tud-pses/powerpathcontroller/doc/ppc.pdf

0.1 Anforderungen

Umschalten zwischen den beiden Spannungsquellen Netzteil und Akku nach folgendem Schema:
- Wenn das Netzteil angeschlossen ist, dann soll dieses, unabhängig von der Akkuspannung, das System speisen. (FF)
- Wenn der Akkupack alleine angeschlossen ist, und dessen Spannung unter einen bestimmten Wert fällt, soll der Akku abgeschaltet werden, und keine Ausgangsspannung zur Verfügung gestellt werden. (WF)
- Zusätzlich soll eine Warnung ausgegeben werden, wenn die Akkuspannung unter eine bestimmte die Grenze fällt. Die Zeit bis zur Abschaltung muss ausreichen, „stressfrei“ das Auto an das Netzteil zu hängen. Diese Warnung soll aber nur ausgegeben werden, wenn tatsächlich ein Akkupack eingesetzt ist. (FF)
- Dar Zustand soll in geeigneter Weise signalisiert werden. (WF)

Eigenschaften Verbraucher
Der zulässige Bereich an Eingangsspannungen für das Mainboard ist 10 V bis 19 V (laut Händler) bzw. 8 V bis 19 V (laut Datenblatt).

Eigenschaften Netzteil
Es handelt sich um ein Schaltnetzteil mit 12 V Nennspannung und 50W Nennleistung.
Das verwendete Netzteil besitzt keine ausgeprägt höhere Leerlaufspannung. (Gemessen sind 12,15 V im Leerlauf, gegenüber 11,96 V bei ausgeschaltetem Rechner (Standby) und 12,14 V bei laufendem Rechner (ohne größere Prozessorlast, mit baugleichem Netzteil).)

Eigenschaften Akkupack
Es handelt sich um ein LiFe-Akkupack mit vier Zellen.
Das Akkupack kann Spannungen bis knapp unter 15 V ausweisen, wenn es gerade vom Ladegerät getrennt wird. (Die verwendete Schutzschaltung würde bei 15,6 V abschalten.)
Die Spannung im Betriebsbereich liegt zwischen 13,25 V und 12,5 V und ist von der Belastung abhängig. Der „makroskopische“ Innenwiderstand (d. h. nach Einschwingvorgängen) ist im Bereich von 65mΩ bis 100mΩ gemessen. Der „instantane“ Innenwiderstand (direkte Spannungsänderung geteilt durch Stromänderung, ohne Einschwingvorgänge abzuwarten) beträgt ca. 30mΩ.
Bei ca. 9,2 V schaltet die Schutzschaltung ab, wobei es im Sinne einer längeren Lebensdauer auch sinnvoll wäre, den Akku vorher von der Last zu trennen. Die nominelle Entladeschlussspannung liegt (laut Wikipedia) bei 10 V bis 11,2 V.

0.2 Abgeleitete Anforderungen

0.2.1 Spannungsgrenzen

Netzteil
- Überspannung : > 14 V
- Unterspannung : < 9,5 V (> 10,5 V)

Die Überspannungsgrenze könnte prinzipiell auch auf 19 V gesetzt werden, da das Mainboard das aushält. Allerdings erhöht das den theoretisch möglichen Umschaltspitzenstrom erheblich, und eine Notwendigkeit, das System mit anderen Netzteilen als den ausgewählten verwenden zu können, besteht nicht.
Die Untergrenze ist auf 9,5 V gelegt, damit eine gewisse Reserve bezüglich einem Spannungseinbruch beim Umschalten auf das Netzteil besteht. Dies stellt auch die absolute Untergrenze dar, wenn man einen Spannungseinbruch von 1 V während des Umschaltens am Ausgang zulässt. Durch die Unsicherheiten kann die tatsächliche Grenze auf 9 V sinken, und damit besteht nur noch 1 V Reserve zu der Mindestspannung von 8 V des Rechners.
Die große Hysterese für die Untergrenze dient dazu, denn quellenseitigen Stützkondensator möglichst klein halten zu können.

Akkupack
- Überspannung : > 15,5 V (< 15 V)
- Unterspannung : < 10,5 V (> 11,5 V)

Mit der Überspannungsgrenze von 15,5 V ist eine Verwendung von auch etwas sehr stark geladenen Akkus möglich. Die Untergrenze von 10,5 V liegt in der Mitte des nominellen Bereichs der Ladeschlussspannung und schützt den Akku vor zu tiefer Entladung. (Die 9,2 V des LiFe-Schützers sind schon sehr niedrig gewählt und schützen mehr vor Zerstörung als vor übermäßigen Verschleiß.) Testmessungen zeigen auch, dass man bei einer niedrigeren Grenze auch nicht viel Zeit gewinnt. (Bei 20W ungefähr eine Minute, bei neuem Akku.)
Die Hysterese von 1 V soll sicherstellen, dass der Akku nicht wieder zugeschaltet wird, wenn sich die Akkuspannung im Leerlauf wieder erhöht. Testmessungen zeigen einen sehr deutlichen Anstieg der Ausgangsspannung des Akkus nach Abschalten der Last, wenn der Akku stark entladen ist. Dieser Anstieg ist umso größer, je größer der Entladestrom ist. Es ist auch mit der Hysterese von 1 V und höheren Entnahmeleistungen nicht ausgeschlossen, dass der Akku sich wieder zuschalten könnte. Letztlich betrifft das aber nur den Fall, dass der Akku abgeschaltet wurde und kein Netzteil angesteckt ist.
Größer kann die Hysterese nicht gewählt werden, da dann der Fall auftreten könnte, dass sich nach dem manuellen Ausschalten bei teilentladenen Akku es sich nicht mehr einschalten lässt. Dies wäre ein unerwünschtes Verhalten.

Warnung Akkupack
- Überspannung : ∞ (nicht überwacht)
- Unterspannung : < 12 V (> 12,25 V)

Bei einer Warngrenze von 12 V und einer Abschaltgrenze von 10,5 V verbleiben bei 20W Leistungsaufnahme ungefähr 5min zwischen Warnung und Abschalten. Bei 60W wären es noch ca. 2,5min. (Jeweils am neuen Akku gemessen.) Dies reicht in allen Fällen für ein „gemütliches“ Anstecken des Netzteils.

0.2.2 Signalisierungen

- LED Netz: an, wenn „Netz VALID“
- LED Akku: an, wenn „Akku VALID“
- LED Akkuwarnung: an, wenn „Akkutest VALID“ und „Akku VALID“

- LED groß, blinkend und Summer Akkuwarnung: an, wenn „Akkutest VALID“ und „Netz VALID“

– Es muss nicht zusätzlich überprüft werden, ob „Akku VALID“ ist. Sollte dies nicht der Fall sein, stünde gar keine Spannung zur Verfügung, und damit würde auch keine Warnung signalisiert werden.
– Die Elemente Blink-LED und Summer müssen nur für den Spannungsbereich zwischen der Unterspannungsgrenze des Akkus und der Unterspannungsgrenze der Akkuwarnung spezifiziert sein. (Dies ist wesentlich, da viele in Frage kommenden Bauteile bis 14 V geeignet sind, und damit nicht an allen zulässigen Akku- und Netzteilspannungen betrieben werden dürfen.)

0.3 Auslegung

0.3.1 Spannungsgrenzen

Gleichungen

Es werden die Bauteilbenennungen aus Abbildung 0.1 verwendet.

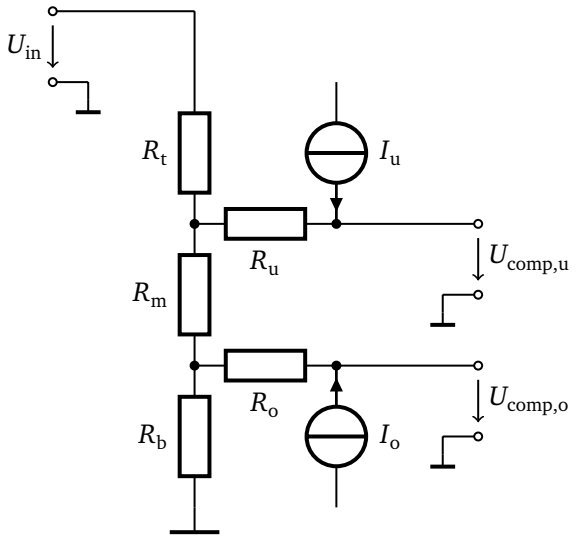
[picture p1: figure]
Uin; Ucomp,u; Ucomp,o

Abbildung 0.1: Schaltplan zur Festlegung der OV/UV-Grenzen

Io = Io,leak | ( +Ihys )
Iu = Iu,leak | ( −Ihys )

Ihys =

63mV
Rhys

Uin,o =

Rt + Rm + Rb
Rb
- Ucomp,o − Rt
- Iu −
Rt + Rm +

Ro

·(Rt + Rm + Rb
)
Rb
- Io

Uin,u =

Rt + Rm + Rb
Rm + Rb
- Ucomp,u −
Rt +

Ru

·(Rt + Rm + Rb
)
Rm + Rb
- Iu −

RtRb
Rm + Rb
- Io

Für die Nominalpunkte ergibt sich

Uov =

Rt + Rm + Rb
Rb
- 1 V

Uuv =

Rt + Rm + Rb
Rm + Rb
- 1 V

Uov,hys =

Rt + Rm +

Ro

·(Rt + Rm + Rb
)
Rb
- Ihys

Uuv,hys =

Rt +

Ru

·(Rt + Rm + Rb
)
Rm + Rb
- Ihys

Festlegung der Bauteilwerte

Hysteresestrom
Da für den Akku eine sehr große Hysterese von 2 V vorgesehen ist, wird der höchstmögliche Hysteresestrom von 500 nA gewählt. Mit der Wahl

Rhys = 127 kΩ

ergibt sich

Ihys =

63mV
127 kΩ

= 496,1 nA

Grenzen Netzteil
Wegen der großen Hysterese ist die „Doppel-T-Struktur“ aus dem Datenblatt verwendet, die für diese Fälle empfohlen ist. Dabei besteht ein Freiheitsgrad, der hier mit der Wahl von Rt = 200 kΩ weggenommen ist. (Dieser Wert orientiert sich an den Werten in den Beispielschaltungen im Datenblatt.)
Mit
Rt = 200 kΩ | Rm = 8,45 kΩ | Rb = 15,0 kΩ | Ru = 200 kΩ | Ro = 20,0 kΩ

erhält man

Uov = 14,90 V | Uov,hys = 0,2512 V | ( Uov − Uov,hys = 14,65 V )

sowie

Uuv = 9,529 V | Uuv,hys = 1,045 V | ( Uuv + Uuv,hys = 10,57 V ) .

Grenzen Akku
Wegen der großen Hysterese ist die „Doppel-T-Struktur“ aus dem Datenblatt verwendet, die für diese Fälle empfohlen ist. Dabei besteht ein Freiheitsgrad, der hier mit der Wahl von Rt = 200 kΩ weggenommen ist. (Dieser Wert orientiert sich an den Werten in den Beispielschaltungen im Datenblatt.)
Mit
Rt = 200 kΩ | Rm = 6,80 kΩ | Rb = 14,3 kΩ | Ru = 174 kΩ | Ro = 51,0 kΩ

erhält man

Uov = 15,46 V | Uov,hys = 0,4938 V | ( Uov − Uov,hys = 14,97 V )

sowie

Uuv = 10,48 V | Uuv,hys = 1,004 V | ( Uuv + Uuv,hys = 11,48 V ) .

Grenzen Akkuwarnung
Mit
Rt = 200 kΩ | Rm = 18,2 kΩ | Rb = 0Ω | Ru = 0Ω | Ro = 0Ω

erhält man

Uuv = 11,99 V | Uuv,hys = 0,0992 V | ( Uuv + Uuv,hys = 12,09 V ) .

Unsicherheitsanalyse

Im Datenblatt sind mögliche Leckströme von

I{o, u},leak = ±20 nA

angegeben. Dazu besitzen die Spannungskomperatoren eine Unsicherheit von pm1,5%,

∆Ucomp,{o, u} = ±1,5% .

Geht man dazu noch von einer Unsicherheit von 1% für Ihys aus (um diese Unsicherheit gering zu halten, wird für Rhys ein 0,1%-Widerstand verwendet), kann die Unsicherheit der sich ergebenden Spannungsschwellen bestimmt werden.
In Abbildung 0.2 ist für jede Schwelle der Bereich der Unsicherheit eingetragen. Zusätzlich zu den oben angegebenen Unsicherheiten sind dabei noch die Unsicherheiten der Widerstände berücksichtigt. Dabei sind 1%-Widerstände (dünne Balken) sowie 0,1%-Widerstände (dünne Balken) berücksichtigt.
Die Schwellen streuen z. T. deutlich. Die Hysteresewerte sind jedoch relativ stabil.

U1,ov U1,ovh U1,uv U1,uvh | U2,ov U2,ovh U2,uv U2,uvh | U3,uv U3,uvh

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
Netzteil | Akku | Akkuwng.

U [V]

U1,ov,hysU1,uv,hysU2,ov,hysU2,uv,hysU3,uv,hys

0

0,2

0,4

0,6

0,8

1

1,2

U [V]

Abbildung 0.2: OV/UV-Grenzen mit Unsicherheit

0.3.2 Leistungspfade

Die „Leistungspfade“ bestehen aus den Mosfets mit der optionalen Slew-Rate-Schaltung sowie den Einund Ausgangskondensatoren.
Abgesehen vom Einschalten (d. h. vom Ausgangszustand, dass keine gültige Spannung anliegt) werden die Mosfets „hart“ geschaltet. Dies kann zu realtiv großen Ausgleichsströmen führen. Neben der Überlastung der Mosfets können diese hohen Ströme auch Spannungseinbrüche der Spannungsquellen hervorrufen, die dazu führen, dass diese den gültigen Bereich verlassen und damit wieder abgeschaltet werden.
Prinzipiell gibt es zwei Möglichkeiten:
- „Überdimensionierte“ Mosfets, die auch große Pulsströme überleben. Dann kann auf die Slew-Rate-Schaltung verzichtet werden.
- Mosfets, die sich am Dauerstrom orientieren.

Ausgangskondensator
Der Ausgangskondensator muss für die Zeit der Umschaltung den Rechner speisen. Die Ausgangsspannung während der Umschaltung soll um maximal 1 V absinken. Geht man von einem ESR von 50mΩ des Ausgangskondensators aus, ergibt sich bei 5 A ein Spannungsabfall von 250mV im Kondensator. Damit beträgt der maximal zulässige Spannungsabfall aufgrund der Entladung 750mA. Die Kapazität des Ausgangskondensators muss damit die Bedingung

CL ≥

5 A ·(3µs + 13µs + ∆tslewrate)
750mV erfüllen, wobei die 3µs + 13µs „systemimmanente“ Umschaltzeit, die überbrückt werden muss, ist. ∆tslewrate ist die zusätzliche Zeit aufgrund der optionalen Slew-Rate-Schaltung und wird nach Datenblatt über

∆tslewrate = 0,79 · RSCS

berechnet.

Eingangskondensator
Im Datenblatt ist für den Eingangskondensator die Bedingung

CU1 ≥ CL
·

U1 − Uout(init)

U1,droop

− 1

angegeben. Diese ergibt sich aus der Eingangsspannung U1 zum Zeitpunkt des Einschaltens der Spannungsquelle 1, der Ausgangsspannung Uout(init) zum Zeitpunkt des Einschaltens und dem zulässigen Spannungseinbruch U1,droop der Spannungsquelle 1. (Die Gleichung basiert auf der Betrachtung des Umladevorgangs von zwei parallelgeschalteten Kondensatoren.)

Eingangskondensator – Netzteil
Als einziges Kriterium wird hier erachtet, dass die Spannungsquelle 1 sich nicht direkt wieder abschalten darf, weil die Unterspannungsbedingung vorliegt. D. h.

U1,droop = U1 − U1,uv .

Damit erhält man

CU1
CL

≥

U1 − Uout(init)

U1 − U1,uv

− 1 .

Der kritische Fall ist hier, wenn das Netzteil durch Einstecken des Netzsteckers eingeschaltet wird. Die Spannung läuft dann „langsam“ hoch, und U1 − U1,uv entspricht gerade der Hysterese U1,uv,hys.
Die niedrigste Spannung Uout(init)
tritt auf, wenn der Akku kurz vor der Unterspannungsschwelle steht. Von dieser müssen dann noch die 0,75 V abgezogen werden, die die Spannung von CL während des Umschaltvorgangs fallen darf.
Somit ergibt sich

U1 = U1,uv + U1,uv,hys = 10,75 V

U1 − U1,uv = U1,uv,hys = 1 V
Uout(init) = 10 V − 0,75 V = 9,25 V.

CU1
CL

≥ 0,5

Eingangskondensator – Akku

CU2
CL

≥

U2 − Uout(init)

U2 − U2,uv

− 1 .

U2 = U2,uv + U2,uv,hys = 12 V

U2 − U2,uv = U2,uv,hys = 1 V
Uout(init) = 9 V − 0,75 V = 8,25 V.

CU2
CL

≥ 2,75

Bei einer Strombegrenzung auf 35 A und einem Innenwiderstand des Akkus von 30mΩ ergibt sich ein Spannungsabfall von 1,05 V. Damit kann sich der Akku in der Regel selber über der Unterspannungsgrenze halten und ein Kondensator ist nicht nötig.

Mosfet

„Schwacher“ Mosfet
- Typ: TPC8120
- VGS,min = −25 V, VGS,max = 20 V
- ID,maxPulse = −72 A
- ID,max = −18 A
- RDS(on) = 3,3mΩ bei VGS = −4,5 V RDS(on) = 2,6mΩ bei VGS = −10 V
- VGS(th),max = −0,8 V, VGS(th),min = −2 V
- CRSS,max = 1,18 nF

0.3.3 Einschaltstrombegrenzung und Pufferkondensator

Da die Eingangsbeschaltung des Boards nicht bekannt ist, kann hierfür kein Widerstand angegeben werden. Der Worst-Case ist ein geringer Widerstand, so dass dieser auf null gesetzt wird.

Rinrush = Rsource + Rfets + (RCL||Rpc,in)

Rfets = 2 · RDS(on) = 5,2mΩ

RCL ist der ESR des Ausgangskondensators der Schaltung und sollte über einen geringen ESR verfügen.

Umschalten von Akku auf Netzteil
Der worst-case Spannungssprung ist von der niedrigsten Akkuspannung minus dem Spannungsabfall während des Umschaltens (10 V − 1 V = 9 V) auf die höchste Netzteilspannung (15,25 V), also 6,25 V.

Rsource = 10mΩ

Rinrush = 20,2mΩ

Iinrush =

6,25 V
20,2mΩ

= 309 A

Umschalten von Netzteil auf Akku
Der worst-case Spannungssprung ist von der niedrigsten Netzteilspannung minus dem Spannungsabfall während des Umschaltens (9 V − 1 V = 8 V) auf die höchste Akkuspannung (16 V), also 8 V.

Rsource = 30mΩ

Rinrush = 40,2mΩ

Iinrush =

8 V
40,2mΩ

= 199 A

Rechnungen „kleiner Mosfet“

Der Kondensator CS der Slew-Rate-Schaltung wir laut Datenblatt zu CS = 10 · CRSS ≈ 12 nF
gewählt.
Mit einem maximalen Pulsstrom von

Iinrush = 35 A
ergibt sich nach dem iterativen Vorgehen aus dem Datenblatt letztlich CL = 470µF
und

RS ≥

(∆VG(sink) − VGS)· 1,2 · CL
CS
- Itot

=

(6 V − 2 V)· 564µF
12 nF · 35 A

= 5,4 kΩ .

Mit der Wahl
RS = 5,6 kΩ
ergibt sich mit
0,79 · RSCS = 0,79 · 5,6 kΩ · 12 nF = 53µs die Bedingung

CL ≥

5 A ·(3µs + 13µs + 53µs)
750mV

= 460µF
für das minimale CL

, welche mit CL = 470µF erfüllt ist.

Eingangskondensator

Rechnungen „großer Mosfet“

Der Ausgangskondensator muss die Bedingung

CL ≥

5 A ·(3µs + 13µs)
750mV

= 107µF

erfüllen. Der nächste Standardtyp (mit etwas Auswahl bei der Spannungsfestigkeit) ist

CL = 150µF .
