tud-pses/powerpathcontroller/doc/tikz/ext/OVUVLimits-ext.pdf

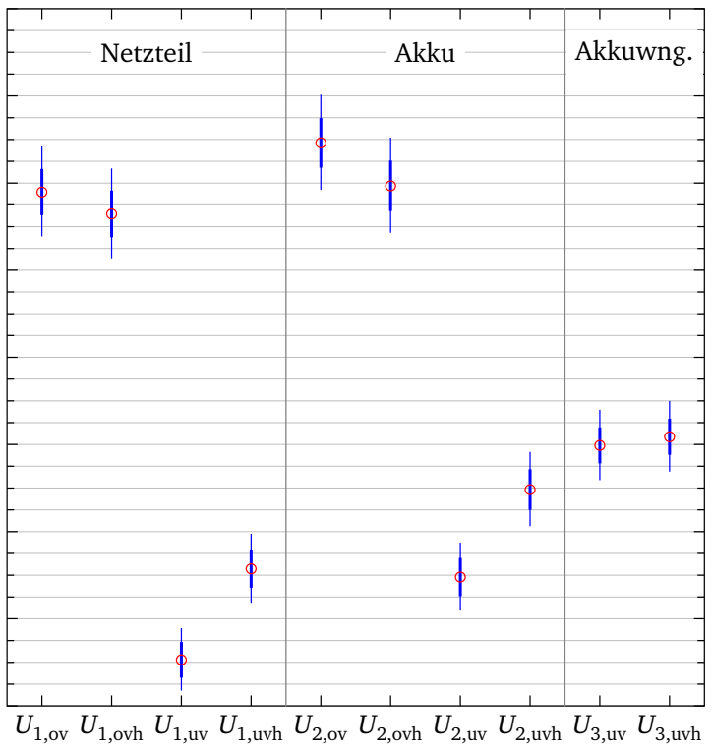
[picture p2: figure]
U1,ov U1,ovh U1,uv U1,uvh; U2,ov U2,ovh U2,uv U2,uvh; U3,uv U3,uvh; Netzteil; Akku; Akkuwng.

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
U [V]

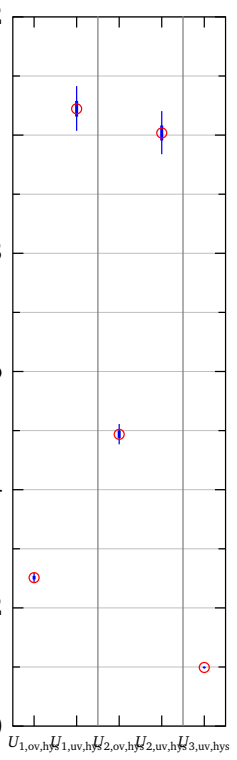
[picture p3: figure]
U1,ov,hysU1,uv,hysU2,ov,hysU2,uv,hysU3,uv,hys

0

0,2

0,4

0,6

0,8

1

1,2

U [V]
