tud-pses/powerpathcontroller/kicad/bom.xlsx

Sheet: Tabelle1
 |  |  |  |  |  |  |  |  | Bestellung
 |  |  |  |  |  |  |  | 29.32 € | Anzahl Platinen: | 2
Referenz | Bezeichnung/wesentliche Eigenschaften | Bauform | Bemerkung | Hersteller | Hersteller-Nr. | Lieferant | Lieferant-Nr. | Preis |  |  | Farnell | Reichelt
U1 | LTC4417 | SSOP 24 narrow |  | Linear | LTC4417IGN#PBF | Farnell | 2293163 | 9.17 € |  |  | 2293163, 2
Cin1 | 470u, 25V | Footprint für RAD FR 1.500/35 geeignet | 35V |  |  | Reichelt | RAD FR 470/35 | 0.23 € |  |  |  | RAD FR 470/35, 2
Cin2 | nb (470u, 25V vorsehen) | Footprint für RAD FR 1.500/35 geeignet | 35V
Cin3 | nb (220u, 25V vorsehen) |  | 35V
Cl1 | 470u, 25V | Footprint für RAD FR 1.500/35 geeignet | 35V |  |  | Reichelt | RAD FR 470/35 | 0.23 € |  |  |  | RAD FR 470/35, 2
Cv1 | 100n, 25V | 0603 | X7R |  |  | Farnell | 1759037 | 0.01 € |  |  | 1759037, 2
Cv2 | 100n, 25V | 0603 | X7R |  |  | Farnell | 1759037 | 0.01 € |  |  | 1759037, 2
Cvs1 | 120n, 25V | 0603 | X7R, 50V |  |  | Farnell | 1793828 | 0.11 € |  |  | 1793828, 2
Cvs2 | 120n, 25V | 0603 | X7R, 50V |  |  | Farnell | 1793828 | 0.11 € |  |  | 1793828, 2
Cs1 | 12n, 25V | 0603 | X7R, 50V |  |  | Farnell | 1865534 | 0.04 € |  |  | 1865534, 2
Cs2 | 12n, 25V | 0603 | X7R, 50V |  |  | Farnell | 1865534 | 0.04 € |  |  | 1865534, 2
Rt1 | 200k | 0603 | 1% |  |  | Farnell | 1469776 | 0.01 € |  |  | 1469776, 2
Rm1 | 8k45 | 0603 | 1% |  |  | Farnell | 2138418 | 0.01 € |  |  | 2138418, 2
Rb1 | 15k0 | 0603 | 1% |  |  | Farnell | 1469758 | 0.01 € |  |  | 1469758, 2
Ru1 | 200k | 0603 | 1% |  |  | Farnell | 1469776 | 0.01 € |  |  | 1469776, 2
Ro1 | 20k0 | 0603 | 1% |  |  | Farnell | 1469774 | 0.02 € |  |  | 1469774, 2
Rt2 | 200k | 0603 | 1% |  |  | Farnell | 1469776 | 0.01 € |  |  | 1469776, 2
Rm2 | 6k80 | 0603 | 1% |  |  | Farnell | 1469831 | 0.01 € |  |  | 1469831, 2
Rb2 | 14k3 | 0603 | 1% |  |  | Farnell | 2138430 | 0.01 € |  |  | 2138430, 2
Ru2 | 174k | 0603 | 1% |  |  | Farnell | 2138522 | 0.02 € |  |  | 2138522, 2
Ro2 | 51k0 | 0603 | 1% |  |  | Farnell | 1469822 | 0.01 € |  |  | 1469822, 2
Rt3 | 200k | 0603 | 1% |  |  | Farnell | 1469776 | 0.01 € |  |  | 1469776, 2
Rm3 | 18k2 | 0603 | 1% |  |  | Farnell | 1652845 | 0.01 € |  |  | 1652845, 2
_Rm3 | 18k2 | 0603 | 1% |  |  | Farnell | 1527611 | 0.08 € |  |  | 1527611, 2
Rhys1 | 127k | 0603 | 1% |  |  | Farnell | 2138509 | 0.02 € |  |  | 2138509, 2
R1 | 100k | 0603 | 1% |  |  | Reichelt | SMD-0603 100K | 0.08 € |  |  |  | SMD-0603 100K, 2
R2 | 100k | 0603 | 1% |  |  | Reichelt | SMD-0603 100K | 0.08 € |  |  |  | SMD-0603 100K, 2
R3 | 100k | 0603 | 1% |  |  | Reichelt | SMD-0603 100K | 0.08 € |  |  |  | SMD-0603 100K, 2
R4 | 4k7 | 0603 | 1% |  |  | Reichelt | SMD-0603 4,7K | 0.08 € |  |  |  | SMD-0603 4,7K, 2
R5 | 4k7 | 0603 | 1% |  |  | Reichelt | SMD-0603 4,7K | 0.08 € |  |  |  | SMD-0603 4,7K, 2
R6 | 4k7 | 0603 | 1% |  |  | Reichelt | SMD-0603 4,7K | 0.08 € |  |  |  | SMD-0603 4,7K, 2
Rs1 | 5k6 | 0603 | 1% |  |  | Reichelt | SMD-0603 5,6K | 0.08 € |  |  |  | SMD-0603 5,6K, 2
Rs2 | 5k6 | 0603 | 1% |  |  | Reichelt | SMD-0603 5,6K | 0.08 € |  |  |  | SMD-0603 5,6K, 2
D1 | LED, gn, 2mA | 0603 |  | Osram | LG L29K | Reichelt | LG L29K | 0.18 € |  |  |  | LG L29K, 2
D2 | LED, gn, 2mA | 0603 |  | Osram | LG L29K | Reichelt | LG L29K | 0.18 € |  |  |  | LG L29K, 2
D3 | LED, rt, 2mA | 0603 |  | Osram | LS L29K | Reichelt | LS L29K | 0.14 € |  |  |  | LS L29K, 2
D4 | Blink-LED, max 12,25 V, min 10 V |  | 8 mm, 800 mcd, 40° Abstrahlwinkel | Kingbright | L-796BSRC-B | Farnell | 1168559 | 0.75 € |  |  | 1168559, 2
_D4 | Blink-LED, max 12,25 V, min 10 V |  | 5 mm, 200 mcd, 60° Abstrahlwinkel | Lumex | SSL-LX5093BSRD | Farnell | 2062466 | 0.79 € |  |  | 2062466, 2
_D4 | Stecker, 2-polig |  |  |  |  | Reichelt | PS 25/2G BR | 0.27 € |  |  |  | PS 25/2G BR, 2
Ds1 | BAT54 | SOT-23 |  |  |  | Reichelt | BAT 54 SMD | 0.04 € |  |  |  | BAT 54 SMD, 2
Ds2 | BAT54 | SOT-23 |  |  |  | Reichelt | BAT 54 SMD | 0.04 € |  |  |  | BAT 54 SMD, 2
D5 | TVS, unidirektional, 16V | SOD123W | ClampVoltage: 26V | NXP | PTVS16VS1UR | Farnell | 1829241 | 0.14 € |  |  | 1829241, 2
D6 | TVS, unidirektional, 16V | SOD123W | ClampVoltage: 26V | NXP | PTVS16VS1UR | Farnell | 1829241 | 0.14 € |  |  | 1829241, 2
Q1 | TPC8120 | SOP 8 |  | Toshiba | TPC8120 | Farnell | 1901967 | 2.17 € |  |  | 1901967, 2
Q2 | TPC8120 | SOP 8 |  | Toshiba | TPC8120 | Farnell | 1901967 | 2.17 € |  |  | 1901967, 2
Q3 | TPC8120 | SOP 8 |  | Toshiba | TPC8120 | Farnell | 1901967 | 2.17 € |  |  | 1901967, 2
Q4 | TPC8120 | SOP 8 |  | Toshiba | TPC8120 | Farnell | 1901967 | 2.17 € |  |  | 1901967, 2
Q5 | TSM3401 | SOT 23 |  |  |  | Reichelt | TSM 3401 SMD | 0.25 € |  |  |  | TSM 3401 SMD, 2
Q6 | TSM3404 | SOT 23 |  |  |  | Reichelt | TSM 3404 SMD | 0.25 € |  |  |  | TSM 3404 SMD, 2
Q7 | TSM3404 | SOT 23 |  |  |  | Reichelt | TSM 3404 SMD | 0.25 € |  |  |  | TSM 3404 SMD, 2
Q8 | TSM3404 | SOT 23 |  |  |  | Reichelt | TSM 3404 SMD | 0.25 € |  |  |  | TSM 3404 SMD, 2
Q9 | TSM3404 | SOT 23 |  |  |  | Reichelt | TSM 3404 SMD | 0.25 € |  |  |  | TSM 3404 SMD, 2
Q10 | Summer, max 12,25 V, min 10 V |  |  | Ekulit | AL-60SP12 | Conrad | 710146 | 0.85 €
X1 | Leistungsstecker, 2 x 3-polig |  | 10 A |  |  | Reichelt | WAGO 713-1403 | 1.20 € |  |  |  | WAGO 713-1403, 2
X2 | Stecker uC, 5 polig |  | 3 A |  |  | Reichelt | PS 25/5G BR | 0.63 € |  |  |  | PS 25/5G BR, 2
 | Buchse für X1 |  |  |  |  | Reichelt | WAGO 713-1103 | 3.20 € |  |  |  | WAGO 713-1103, 2

Sheet: Tabelle2
Lieferant | Lieferant-Nr.
Farnell | 2293163
Reichelt | RAD FR 470/35
Reichelt | RAD FR 470/35
Farnell | 1759037
Farnell | 1759037
Farnell | 1793828
Farnell | 1793828
Farnell | 1865534
Farnell | 1865534
Farnell | 1469776
Farnell | 2138418
Farnell | 1469758
Farnell | 1469776
Farnell | 1469774
Farnell | 1469776
Farnell | 1469831
Farnell | 2138430
Farnell | 2138522
Farnell | 1469822
Farnell | 1469776
Farnell | 1652845
Farnell | 2138509
Reichelt | SMD-0603 100K
Reichelt | SMD-0603 100K
Reichelt | SMD-0603 100K
Reichelt | SMD-0603 4,7K
Reichelt | SMD-0603 4,7K
Reichelt | SMD-0603 4,7K
Reichelt | SMD-0603 5,6K
Reichelt | SMD-0603 5,6K
Reichelt | LG L29K
Reichelt | LG L29K
Reichelt | LS L29K
Farnell | 1168559
Farnell | 2062466
Reichelt | PS 25/2G BR
Reichelt | BAT 54 SMD
Reichelt | BAT 54 SMD
Farnell | 1829241
Farnell | 1829241
Farnell | 1901967
Farnell | 1901967
Farnell | 1901967
Farnell | 1901967
Reichelt | TSM 3401 SMD
Reichelt | TSM 3404 SMD
Reichelt | TSM 3404 SMD
Reichelt | TSM 3404 SMD
Reichelt | TSM 3404 SMD
Reichelt | SUMMER AL-60P12
Reichelt | WAGO 713/1403
Reichelt | PS 25/5G BR
Reichelt | WAGO 713-1103
