tud-pses/powerpathcontroller/kicad/PowerPathController.kicad_pcb

## KiCad design kicad/PowerPathController.kicad_pcb (2018-07-06)

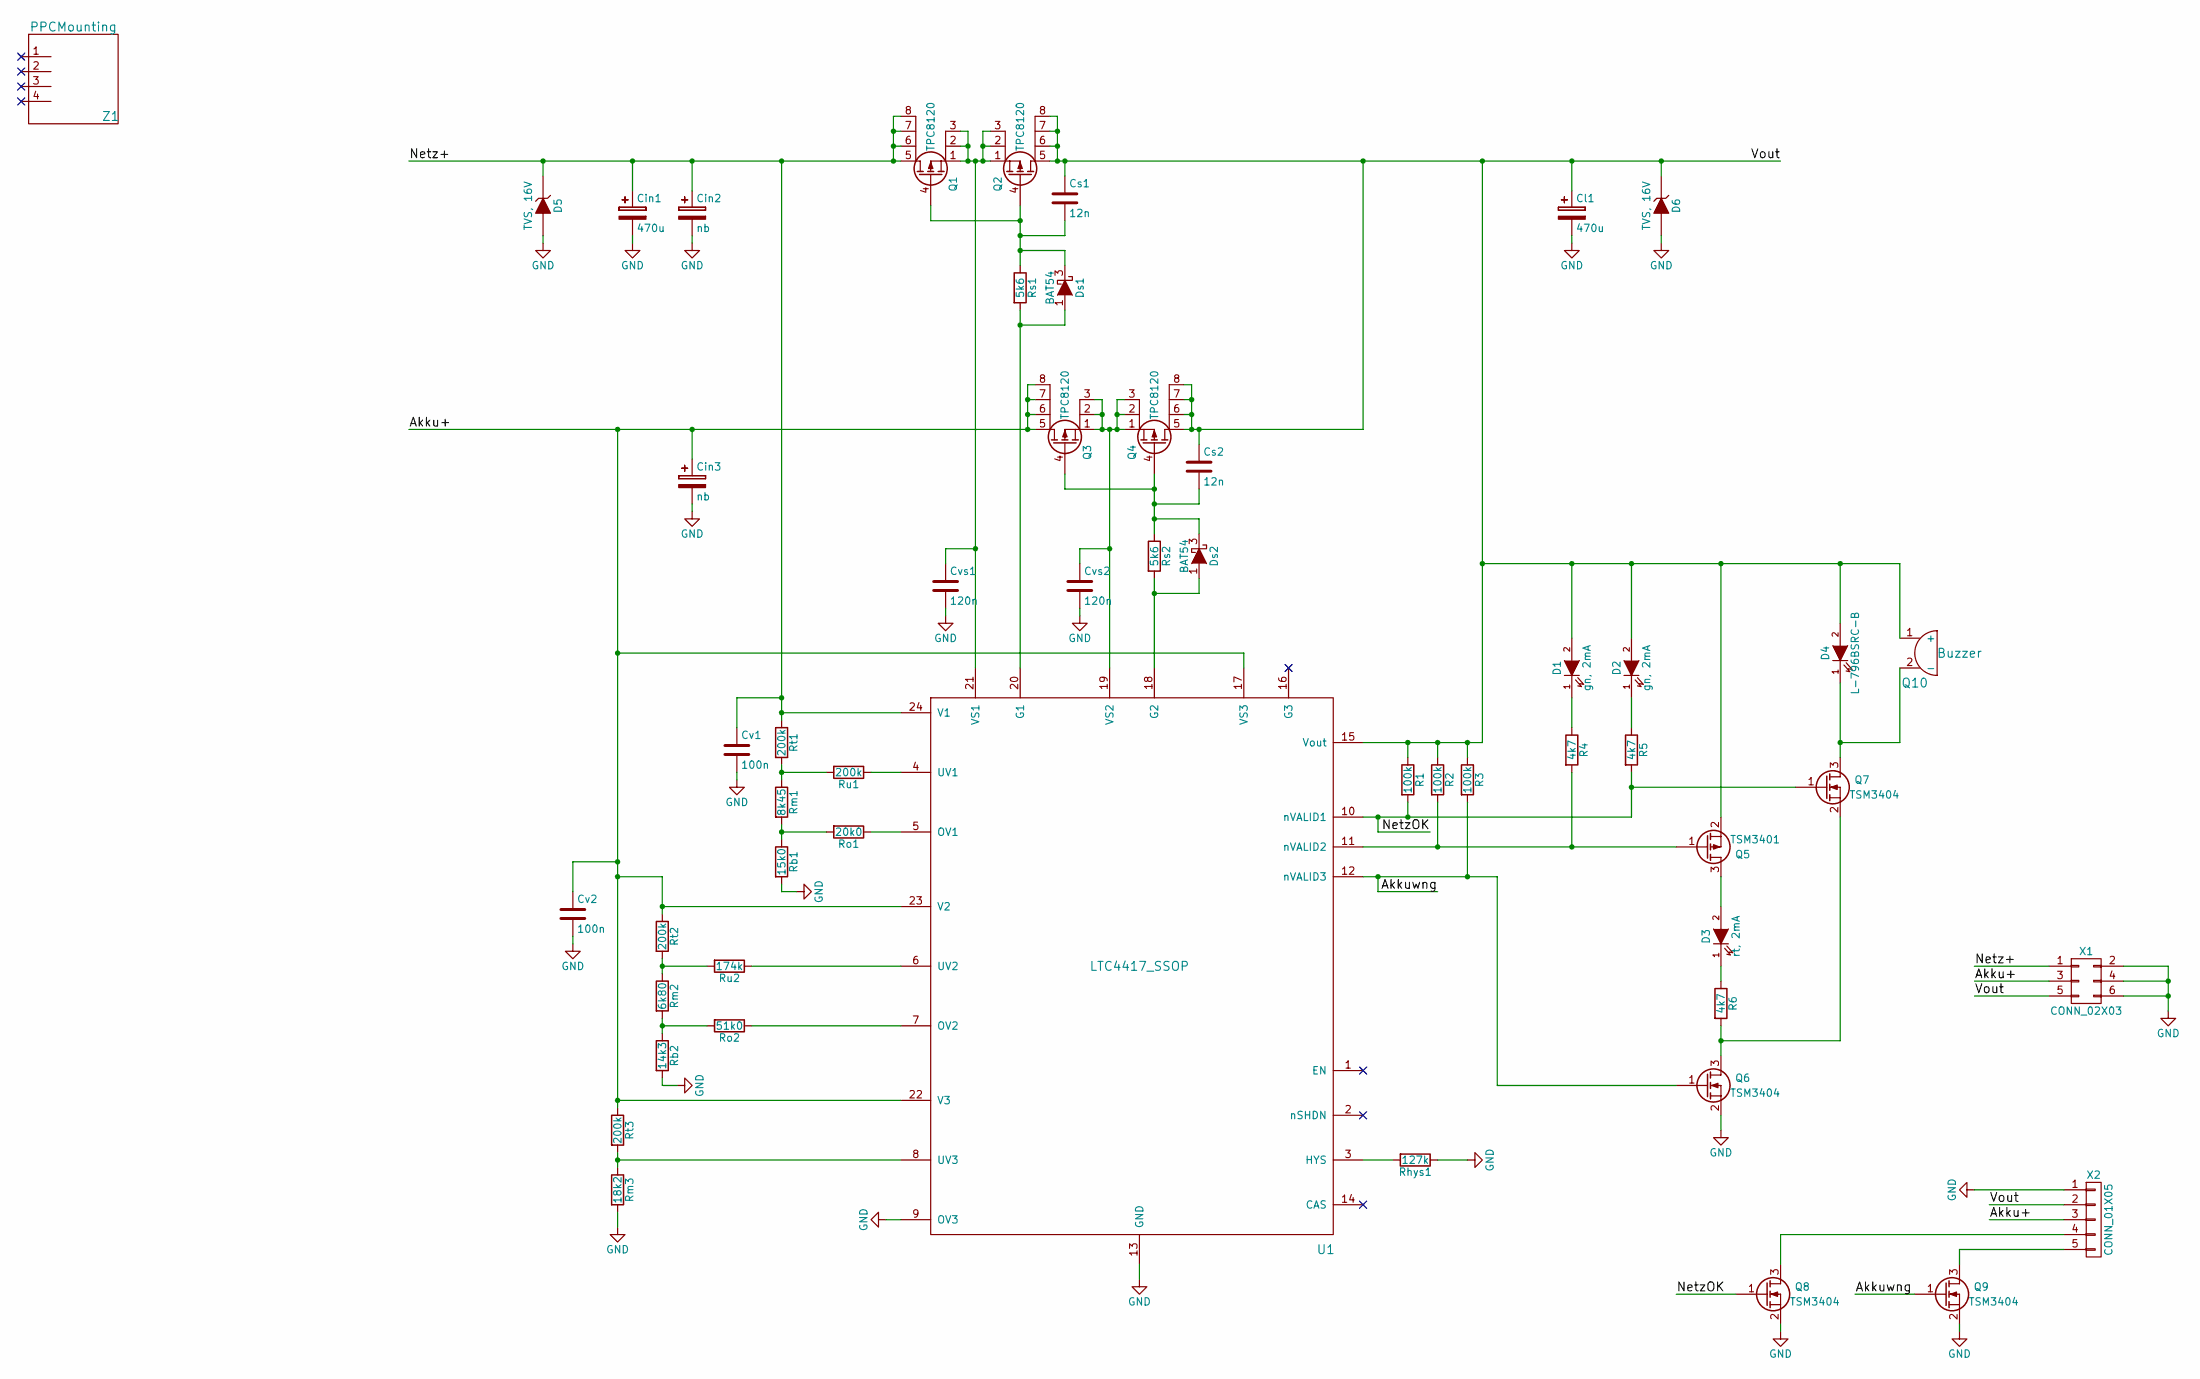
[picture p4: schematic PowerPathController.sch]

Parts:
Cin1: 470u; CPOL_12.5o8mm_5o3.5mm
Cin2: nb; CPOL_12.5o8mm_5o3.5mm
Cin3: nb; CPOL_8mm_3.5mm
Cl1: 470u; CPOL_12.5o8mm_5o3.5mm
Cs1, Cs2: 12n; C_0603_HandSoldering
Cv1, Cv2: 100n; C_0603_HandSoldering
Cvs1, Cvs2: 120n; C_0603_HandSoldering
D1, D2: gn, 2mA; LED-0603
D3: rt, 2mA; LED-0603
D4: L-796BSRC-B; LED-8MM_o_CONN_PS25_2G
D5, D6: TVS, 16V; SOD-123W
Ds1, Ds2: BAT54; SOT-23_Handsoldering
Q1, Q2, Q3, Q4: TPC8120; SOIC-8_3.9x4.9mm_Pitch1.27mm
Q5: TSM3401; SOT-23_Handsoldering
Q6, Q7, Q8, Q9: TSM3404; SOT-23_Handsoldering
Q10: Buzzer; Buzzer_AL-60P12
R1, R2, R3: 100k; R_0603_HandSoldering
R4, R5, R6: 4k7; R_0603_HandSoldering
Rb1: 15k0; R_0603_HandSoldering
Rb2: 14k3; R_0603_HandSoldering
Rhys1: 127k; R_0603_HandSoldering
Rm1: 8k45; R_0603_HandSoldering
Rm2: 6k80; R_0603_HandSoldering
Rm3: 18k2; R_0603_HandSoldering
Ro1: 20k0; R_0603_HandSoldering
Ro2: 51k0; R_0603_HandSoldering
Rs1, Rs2: 5k6; R_0603_HandSoldering
Rt1, Rt2, Rt3: 200k; R_0603_HandSoldering
Ru1: 200k; R_0603_HandSoldering
Ru2: 174k; R_0603_HandSoldering
U1: LTC4417_SSOP; SSOP-24_3.9x8.7mm_Pitch0.635mm
X1: CONN_02X03; WAGO_713-1403
X2: CONN_01X05; CONN_PS25_5G
Z1: PPCMounting; PPCMOUNTING

Connections:
/Akku+: Cin3.1, Cv2.1, Q3.5 (D), Q3.6 (D), Q3.7 (D), Q3.8 (D), Rt2.1, Rt3.1, U1.17 (VS3), U1.22 (V3), U1.23 (V2), X1.3, X2.3
/Akkuwng: Q6.1 (G), Q9.1 (G), R3.2, U1.12 (nVALID3)
/Netz+: Cin1.1, Cin2.1, Cv1.1, D5.1 (K), Q1.5 (D), Q1.6 (D), Q1.7 (D), Q1.8 (D), Rt1.1, U1.24 (V1), X1.1
/NetzOK: Q7.1 (G), Q8.1 (G), R1.2, R5.2, U1.10 (nVALID1)
/Vout: Cl1.1, Cs1.1, Cs2.1, D1.2 (A), D2.2 (A), D4.2 (A), D6.1 (K), Q2.5 (D), Q2.6 (D), Q2.7 (D), Q2.8 (D), Q4.5 (D), Q4.6 (D), Q4.7 (D), Q4.8 (D), Q5.2 (S), Q10.1 (+), R1.1, R2.1, R3.1, U1.15 (Vout), X1.5, X2.2
GND: Cin1.2, Cin2.2, Cin3.2, Cl1.2, Cv1.2, Cv2.2, Cvs1.2, Cvs2.2, D5.2 (A), D6.2 (A), Q6.2 (S), Q8.2 (S), Q9.2 (S), Rb1.2, Rb2.2, Rhys1.1, Rm3.2, U1.9 (OV3), U1.13 (GND), X1.2, X1.4, X1.6, X2.1
unnamed: Cs1.2, Ds1.3 (K), Q1.4 (G), Q2.4 (G), Rs1.1
unnamed: Cs2.2, Ds2.3 (K), Q3.4 (G), Q4.4 (G), Rs2.1
unnamed: Cvs1.1, Q1.1 (S), Q1.2 (S), Q1.3 (S), Q2.1 (S), Q2.2 (S), Q2.3 (S), U1.21 (VS1)
unnamed: Cvs2.1, Q3.1 (S), Q3.2 (S), Q3.3 (S), Q4.1 (S), Q4.2 (S), Q4.3 (S), U1.19 (VS2)
unnamed: D1.1 (K), R4.1
unnamed: D2.1 (K), R5.1
unnamed: D3.1 (K), R6.1
unnamed: D3.2 (A), Q5.3 (D)
unnamed: D4.1 (K), Q7.3 (D), Q10.2 (-)
unnamed: Ds1.1 (A), Rs1.2, U1.20 (G1)
unnamed: Ds2.1 (A), Rs2.2, U1.18 (G2)
unnamed: Q5.1 (G), R2.2, R4.2, U1.11 (nVALID2)
unnamed: Q6.3 (D), Q7.2 (S), R6.2
unnamed: Q8.3 (D), X2.4
unnamed: Q9.3 (D), X2.5
unnamed: Rb1.1, Rm1.2, Ro1.2
unnamed: Rb2.1, Rm2.2, Ro2.2
unnamed: Rhys1.2, U1.3 (HYS)
unnamed: Rm1.1, Rt1.2, Ru1.2
unnamed: Rm2.1, Rt2.2, Ru2.2
unnamed: Rm3.1, Rt3.2, U1.8 (UV3)
unnamed: Ro1.1, U1.5 (OV1)
unnamed: Ro2.1, U1.7 (OV2)
unnamed: Ru1.1, U1.4 (UV1)
unnamed: Ru2.1, U1.6 (UV2)

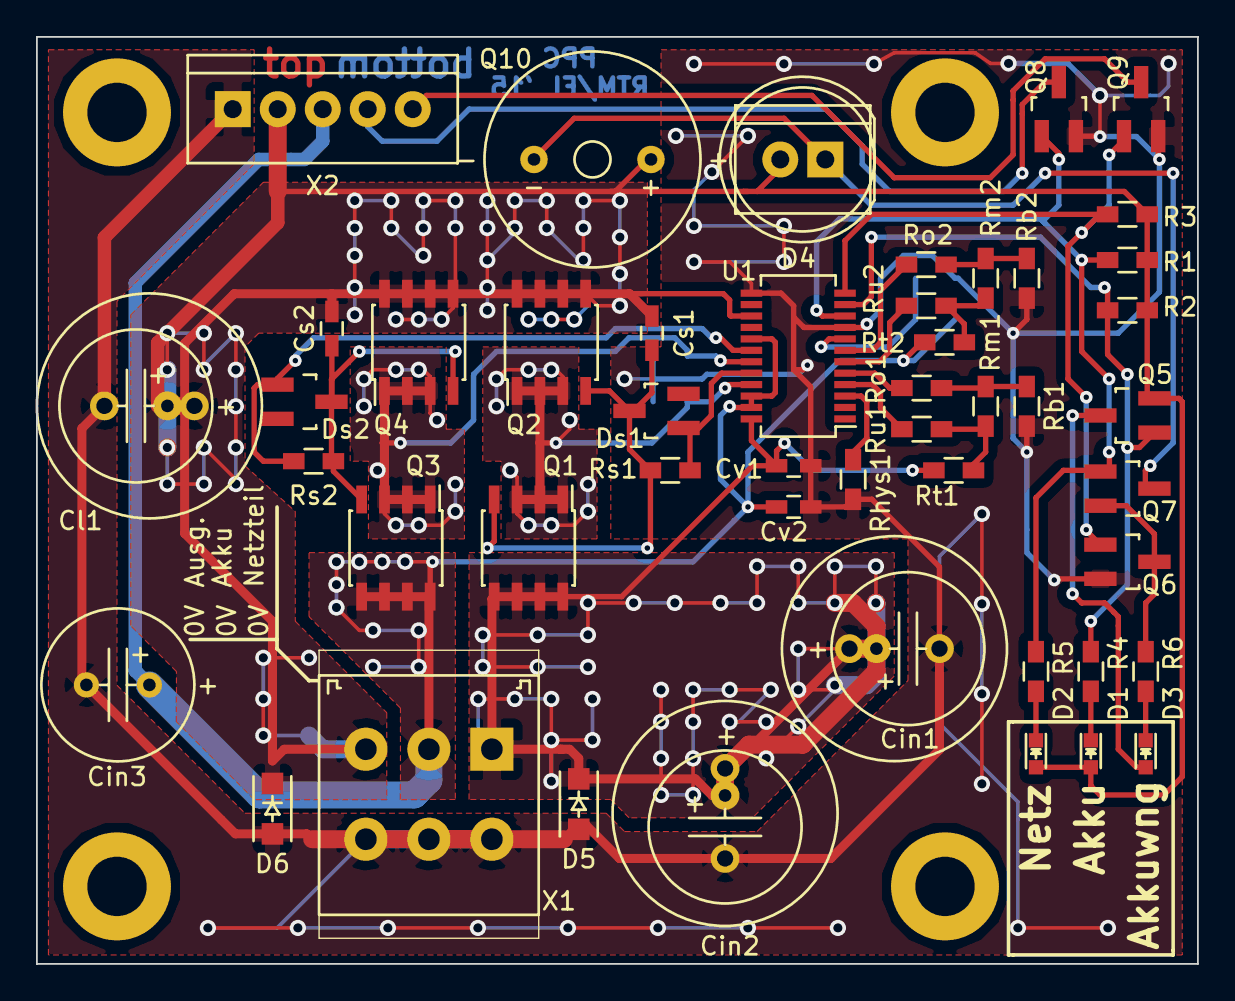
[picture p5: board PowerPathController.kicad_pcb from above]

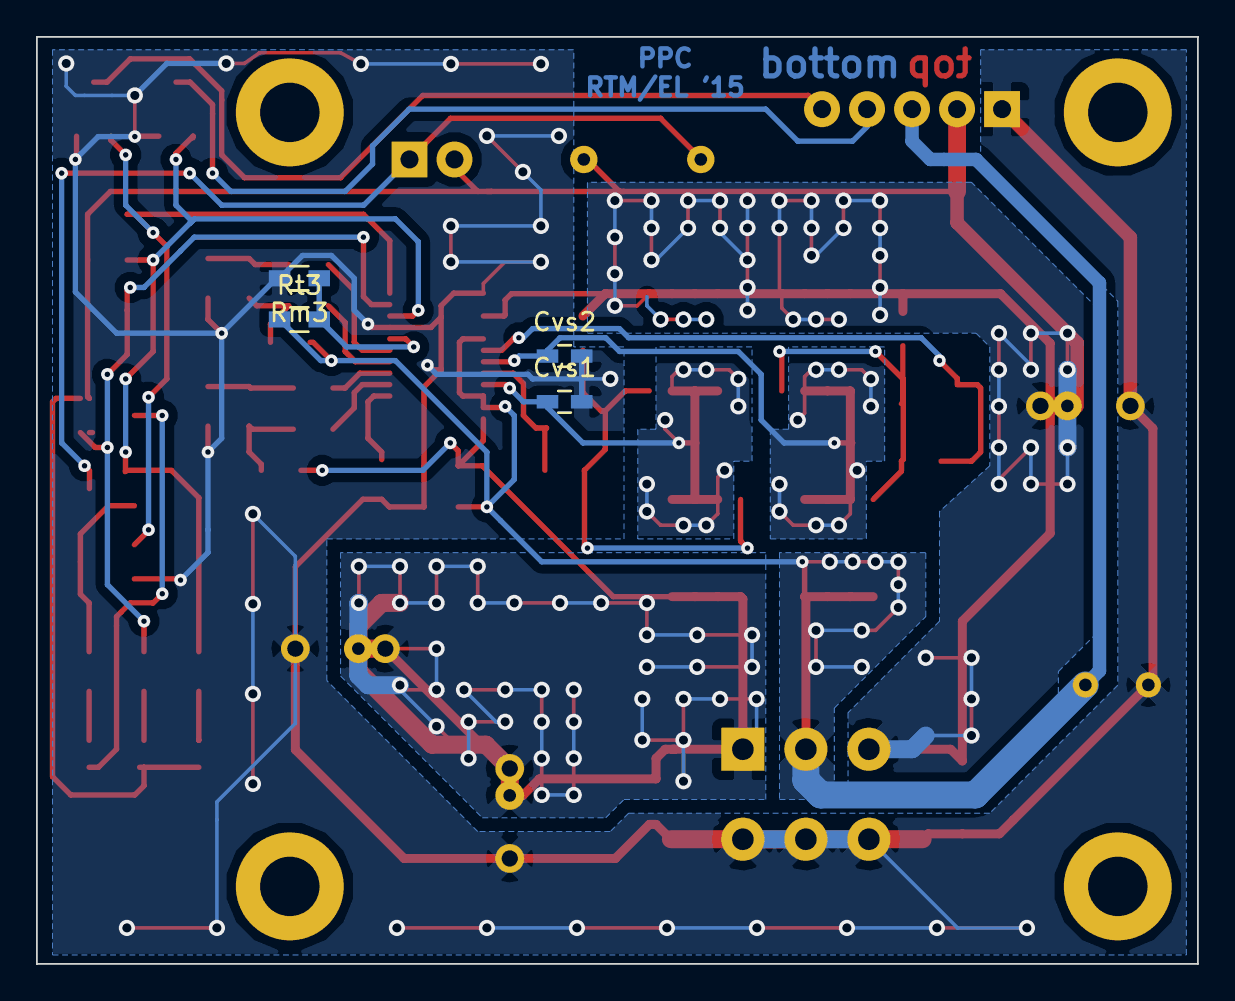
[picture p6: board PowerPathController.kicad_pcb from below]

Board: 2 copper layers, 64.5 x 51.5 mm, 53 parts (4 on the bottom side), 31 nets.
